Houzezhen/Seven-way-responder----Practice-of-electronic-circuit-design/原理图pdf.pdf

# 5V供电

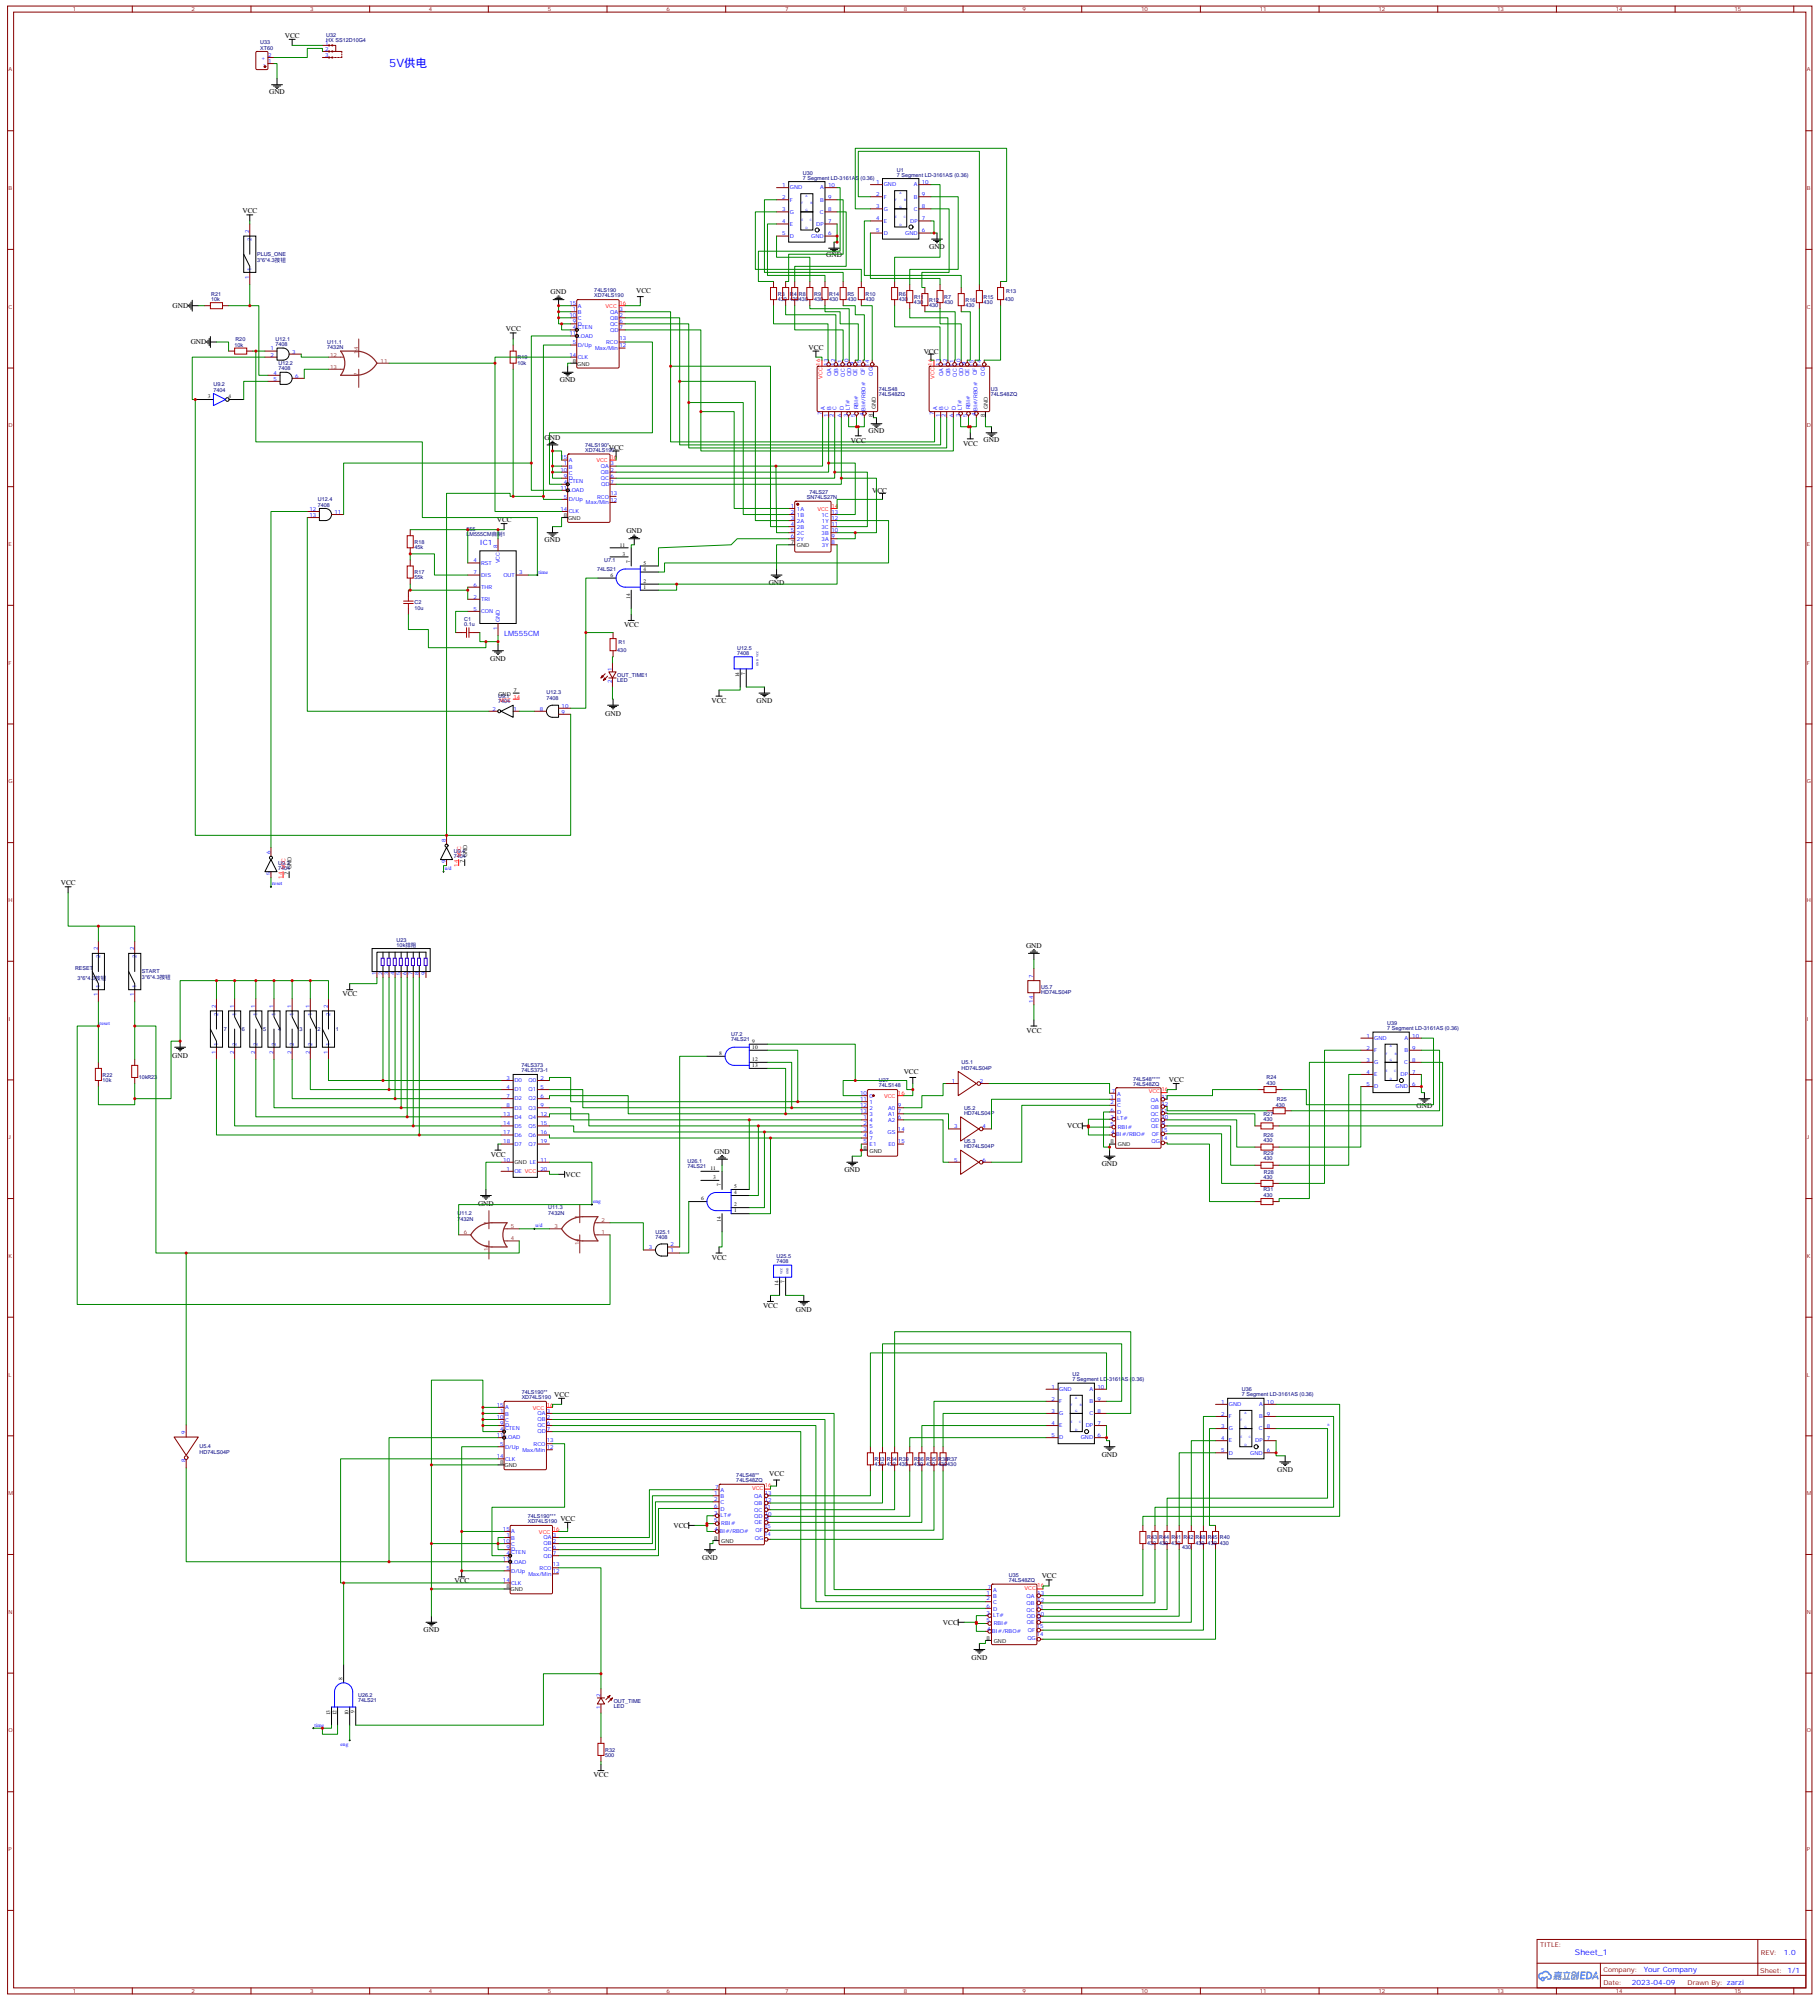
[picture p1: page 1]
