Houzezhen/Seven-way-responder----Practice-of-electronic-circuit-design/(list of files, drawings)

Other design files:
7路抢答器.ms14
