Houzezhen/Seven-way-responder----Practice-of-electronic-circuit-design/(commit log)

2024-09-01 七路抢答器
    [7路抢答器侯泽镇2115103011.ms14]
2024-09-01 七路抢答器-修改
    [7路抢答器.ms14]
